dlsingh/temp_varun_rx_ant_UFL/README.md

this repo contains files rof varun rx with UFL antenna project
