dlsingh/temp_varun_rx_ant_UFL/varun_nr_at826_rx_bom_0.2_PCB_pwr.xlsx

Component | References | Value | Footprint | Supplied By | Quantity Per PCB | MFPN | Manufacturer | Distributor | Description | Vendor
1 | AE201 | SMA_Antenna |  | DYU Labs | 1 | Generic | Generic | Robu | Antenna with extra pin for shielding
2 | C1 | 220uF | CP_Radial_D6.3mm_P2.50mm | PCB Power | 1 | ESH227M010AE3AA | KEMET | Mouser | Polarized capacitor, small US symbol
3 | C102 C202 C401 | 0.1uF, 10V | C_0402_1005Metric | PCB Power | 3 | 0402ZD104KAT4A | kyocera AVX | Mouser | Unpolarized capacitor, small symbol | AVX
4 | C101 C201 | 10uF, 10V | C_1206_3216Metric | PCB Power | 2 | TAJA106K010SNJ | kyocera AVX | Mouser | Polarized capacitor, small symbol
5 | C2 C3 | 1uF, 10V | C_0805_2012Metric | PCB Power | 2 | CC0805KKX7R6BB105 | Yageo | Mouser | Unpolarized capacitor, small symbol
6 | D2 | AC_LED | LED_D3.0mm | DYU Labs | 1 | MCL034PT | Multicomp Pro | Element14 | Light emitting diode
7 | D1 | AS1M-HF | D_SMA | PCB Power | 1 | AS1M-HF | Comchip | Mouser | 1000V 1A General Purpose Rectifier Diode, DO-41
8 | D101 | LED_BGRA | LED_Cree_RGB_1.00x1.00mm_P0.2mm | PCB Power | 1 | uhd1110-fka-cl1a13r3q1bbqfmf3 | Cree LED | Mouser | RGB LED, blue/green/red/anode
9 | D3 | POWER_LED | LED_D3.0mm | DYU Labs | 1 | MCL034GT | Multicomp Pro | Element14 | Light emitting diode
10 | D301 D302 | S1M-HF | D_SMA | PCB Power | 2 | S1M-HF | Comchip | Mouser | 1000V, 1A, General Purpose Rectifier Diode, SMA(DO-214AC)
11 | F1 | Fuse_0.5A | Fuse_Schurter_UMT250 | PCB Power | 1 | 3405.0163.24 | Schurter | Mouser | Fuse, small symbol
12 | J103 | Conn_01x03 | PinHeader_1x03_P2.54mm_Vertical | DYU Labs | 1 | 22284030 | Molex | Generic | Generic connector, single row, 01x03, script generated (kicad-library-utils/schlib/autogen/connector/)
13 | J104 J401 | Conn_01x03 | JST_PH_B3B-PH-K_1x03_P2.00mm_Vertical | DYU Labs | 2 | B3B-PH-KS | JST | Generic | Generic connector, single row, 01x03, script generated (kicad-library-utils/schlib/autogen/connector/)
14 | J202 | Conn_Coaxial | SMA_Amphenol_901-143_Horizontal | DYU Labs | 1 | 73391-0083 | Molex | Mouser | coaxial connector (BNC, SMA, SMB, SMC, Cinch/RCA, LEMO, ...)
15 | J1 J302 J303 | Screw_Terminal_01x02 | CUI_TB002-500-02BE | PCB Power | 3 | TB002-500-02BE | CUI Devices | Mouser | Generic screw terminal, single row, 01x02, script generated (kicad-library-utils/schlib/autogen/connector/)
16 | K301 K302 | AZ943-1CH-5DE | Relay_SPDT_SANYOU_SRD_Series_Form_C | PCB Power | 2 | AZ943-1CH-5DE | American Zettler | DigiKey | Omron G5LE relay, Miniature Single Pole, SPDT, 10A
17 | PS1 | HLK-PM01 | Converter_ACDC_HiLink_HLK-PMxx | DYU Labs | 1 | HLK-PM01 | HiLink | Rajguru | Compact AC/DC board mount power module 3W 5V
18 | Q301 Q302 | Q_NPN_BEC | TSOT-23 | PCB Power | 2 | PMBT3904,235 | Nexperia | Mouser | NPN transistor, base/emitter/collector
19 | R2 R104 R105 R106 | 220 | R_0402_1005Metric | PCB Power | 4 | WR04X221JTL | Walsin | Mouser | Resistor, small US symbol
20 | R301 R302 | 2.74K | R_0402_1005Metric | PCB Power | 2 | WR04X2741FTL | Walsin | Mouser | Resistor, small US symbol
21 | R102 | 10K | R_0402_1005Metric | PCB Power | 1 | WR04X103JTL | Walsin | Mouser | Resistor, small US symbol
22 | R1 | 100K | R_0805_2012Metric | PCB Power | 1 | ERJ-P06J104V | KOA Speer | Mouser | Resistor, small US symbol
23 | RV1 | 10D561 | RV_Disc_D12mm_W5.1mm_P7.5mm | PCB Power | 1 | MOV-10D561K | Bornus | Mouser | Voltage dependent resistor, US symbol
24 | SW102 | SW_MEC_5E | RKB2SJM250SMTR_LFS_SWITCH | PCB Power | 1 | PTS815 SJM 250 SMTR LFS |  | Mouser | MEC 5E single pole normally-open tactile switch
25 | U101 | ATtiny826-M | VQFN-20-1EP_3x3mm_P0.4mm_EP1.7x1.7mm | DYU Labs | 1 | ATTINY826-M | Microchip | Mouser | 20MHz, 8kB Flash, 1kB SRAM, 128B EEPROM, VQFN-20
26 | U1 | NCP115ASN330T2G | TSOP-5_1.65x3.05mm_P0.95mm | PCB Power | 1 | NCP115ASN330T2G | Onsemi | Mouser
27 | U201 | NiceRF-LoRa127x-C1-xxx | NiceRF-LoRa127X-C1-xxx | DYU Labs | 1 | Lora1276-C1-868 | NiceRF | NiceRF
Component Groups: | 30
Component Count: | 44
Fitted Components: | 41
Number of PCBs: | 1
Total components: | 41
Schematic Version: | 0.2
Schematic Date: | 2022-08-05
PCB Variant: | a
BoM Date: | 2022-08-16 11:27
Schematic Source: | varun_nr_at826_rx.kicad_sch
KiCad Version: | Eeschema (6.0.1)
