dlsingh/temp_varun_rx_ant_UFL/varun_nr_at826_rx.kicad_pcb

## KiCad design varun_nr_at826_rx.kicad_pcb (2022-08-17)

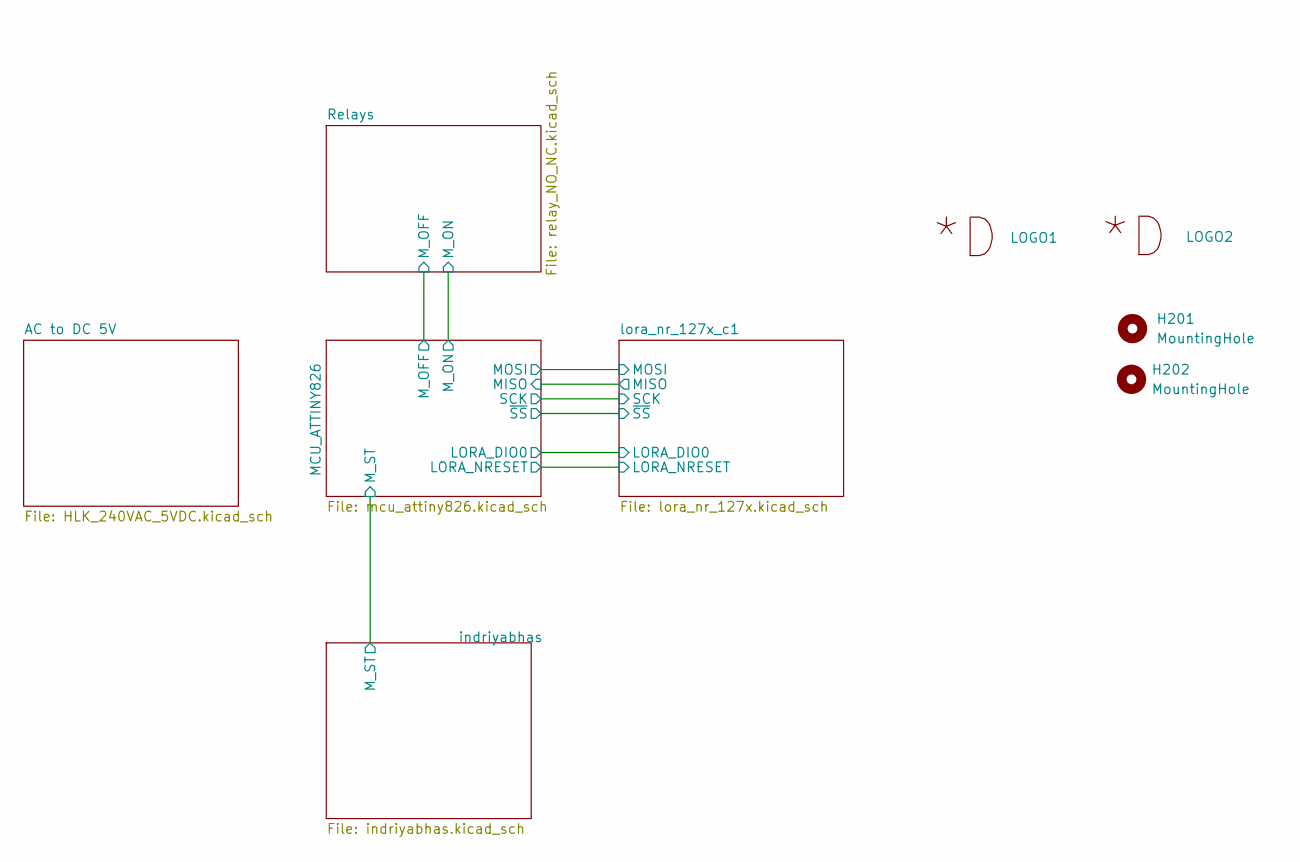
[picture p1: schematic varun_nr_at826_rx.kicad_sch, varun_rx]

Parts:
H201, H202: MountingHole; MountingHole_3mm
LOGO1, LOGO2: Dyulabs_logo; D_logo

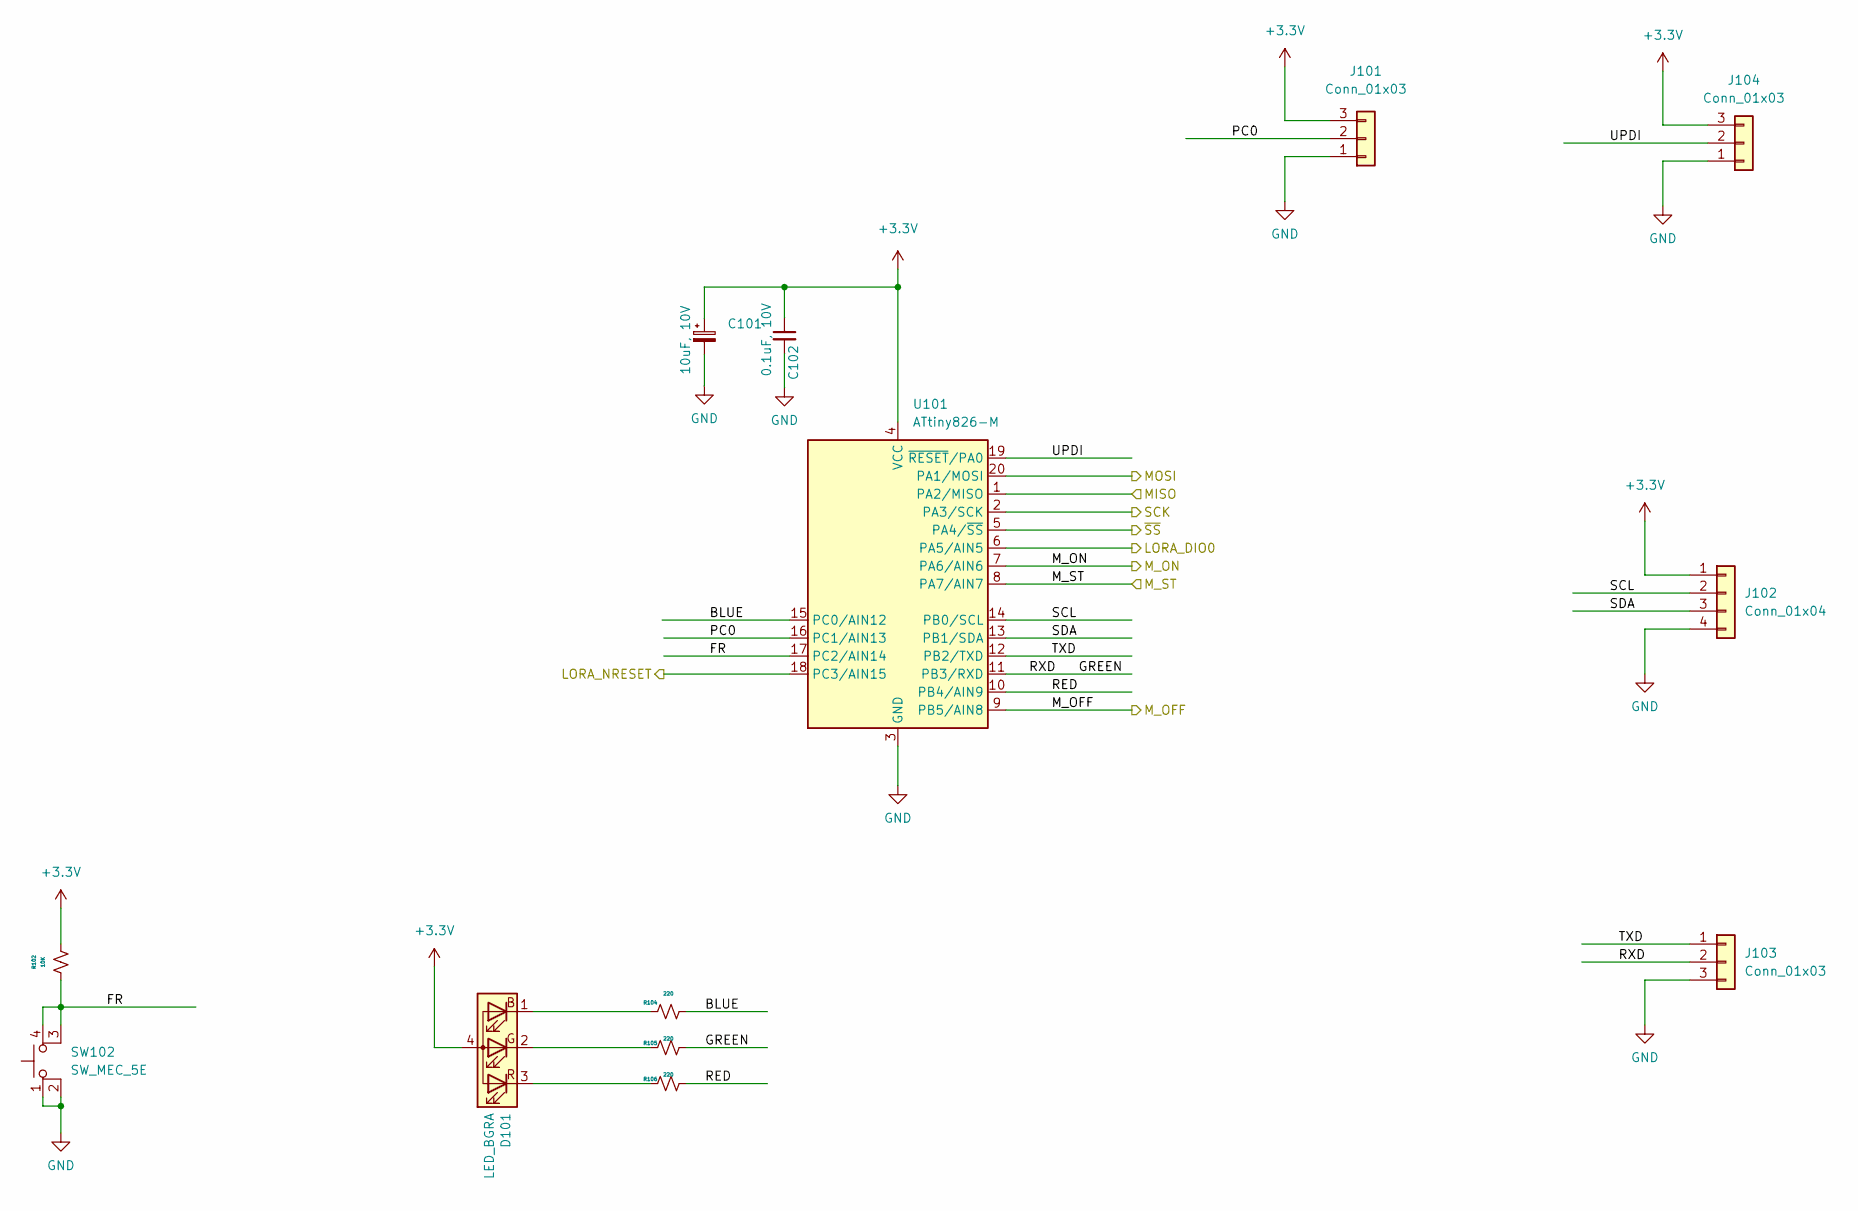
[picture p2: schematic mcu_attiny826.kicad_sch, varun_rx]

Parts:
C101: 10uF, 10V; C_1206_3216Metric
C102: 0.1uF, 10V; C_0402_1005Metric
D101: LED_BGRA; LED_Cree_RGB_1.00x1.00mm_P0.2mm
J101, J103: Conn_01x03; PinHeader_1x03_P2.54mm_Vertical
J102: Conn_01x04; PinHeader_1x04_P2.54mm_Vertical
J104: Conn_01x03; JST_PH_B3B-PH-K_1x03_P2.00mm_Vertical
R102: 10K; R_0402_1005Metric
R104, R105, R106: 220; R_0402_1005Metric
SW102: SW_MEC_5E; RKB2SJM250SMTR_LFS_SWITCH
U101: ATtiny826-M; VQFN-20-1EP_3x3mm_P0.4mm_EP1.7x1.7mm

Connections:
+3V3: C101.1, C102.1, D101.4 (A), J101.3, J102.1, J104.3, R102.2, U101.4 (VCC); also elsewhere on the board
/MCU_ATTINY826/BLUE: R104.1, U101.15 (PC0/AIN12)
/MCU_ATTINY826/FR: R102.1, SW102.3 (K), SW102.4 (A), U101.17 (PC2/AIN14)
/MCU_ATTINY826/GREEN: J103.2, R105.1, U101.11 (PB3/RXD)
/MCU_ATTINY826/LORA_DIO0: U101.6 (PA5/AIN5); also elsewhere on the board
/MCU_ATTINY826/LORA_NRESET: U101.18 (PC3/AIN15); also elsewhere on the board
/MCU_ATTINY826/MISO: U101.1 (PA2/MISO); also elsewhere on the board
/MCU_ATTINY826/MOSI: U101.20 (PA1/MOSI); also elsewhere on the board
/MCU_ATTINY826/M_OFF: U101.9 (PB5/AIN8); also elsewhere on the board
/MCU_ATTINY826/M_ON: U101.7 (PA6/AIN6); also elsewhere on the board
/MCU_ATTINY826/M_ST: U101.8 (PA7/AIN7); also elsewhere on the board
/MCU_ATTINY826/PC0: J101.2, U101.16 (PC1/AIN13)
/MCU_ATTINY826/RED: R106.1, U101.10 (PB4/AIN9)
/MCU_ATTINY826/SCK: U101.2 (PA3/SCK); also elsewhere on the board
/MCU_ATTINY826/SCL: J102.2, U101.14 (PB0/SCL)
/MCU_ATTINY826/SDA: J102.3, U101.13 (PB1/SDA)
/MCU_ATTINY826/TXD: J103.1, U101.12 (PB2/TXD)
/MCU_ATTINY826/UPDI: J104.2, U101.19 (~RESET/PA0)
/MCU_ATTINY826/~SS: U101.5 (PA4/~SS); also elsewhere on the board
GND: C101.2, C102.2, J101.1, J102.4, J103.3, J104.1, SW102.1, SW102.2, U101.3 (GND), U101.21 (GND); also elsewhere on the board
unnamed: D101.1 (BK), R104.2
unnamed: D101.2 (GK), R105.2
unnamed: D101.3 (RK), R106.2

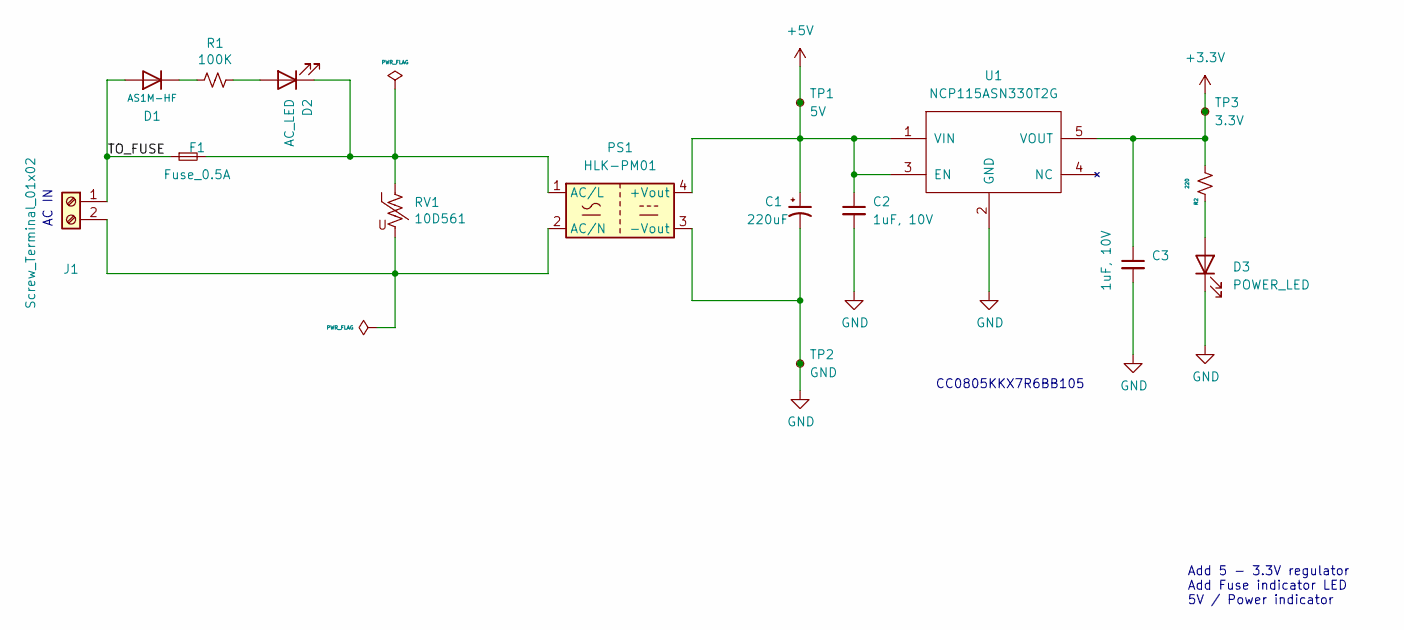
[picture p3: schematic HLK_240VAC_5VDC.kicad_sch, varun_rx]

Parts:
C1: 220uF; CP_Radial_D6.3mm_P2.50mm
C2, C3: 1uF, 10V; C_0805_2012Metric
D1: AS1M-HF; D_SMA
D2: AC_LED; LED_D3.0mm
D3: POWER_LED; LED_D3.0mm
F1: Fuse_0.5A; Fuse_Schurter_UMT250
J1: Screw_Terminal_01x02; CUI_TB002-500-02BE
PS1: HLK-PM01; Converter_ACDC_HiLink_HLK-PMxx
R1: 100K; R_0805_2012Metric
R2: 220; R_0402_1005Metric
RV1: 10D561; RV_Disc_D12mm_W5.1mm_P7.5mm
TP1: 5V; TestPoint_THTPad_D1.0mm_Drill0.5mm
TP2: GND; TestPoint_THTPad_D1.0mm_Drill0.5mm
TP3: 3.3V; TestPoint_THTPad_D1.0mm_Drill0.5mm
U1: NCP115ASN330T2G; TSOP-5_1.65x3.05mm_P0.95mm

Connections:
+3V3: C3.1, R2.1, TP3.1, U1.5 (VOUT); also elsewhere on the board
+5V: C1.1, C2.1, PS1.4 (+Vout), TP1.1, U1.1 (VIN), U1.3 (EN); also elsewhere on the board
/AC to DC 5V/TO_FUSE: D1.2 (A), F1.1, J1.1
GND: C1.2, C2.2, C3.2, D3.1 (K), PS1.3 (-Vout), TP2.1, U1.2 (GND); also elsewhere on the board
unnamed: D1.1 (K), R1.2
unnamed: D2.1 (K), F1.2, PS1.1 (AC/L), RV1.1
unnamed: D2.2 (A), R1.1
unnamed: D3.2 (A), R2.2
unnamed: J1.2, PS1.2 (AC/N), RV1.2

Notes on the sheet:
AC IN
CC0805KKX7R6BB105
Add 5 - 3.3V regulator Add Fuse indicator LED 5V / Power indicator

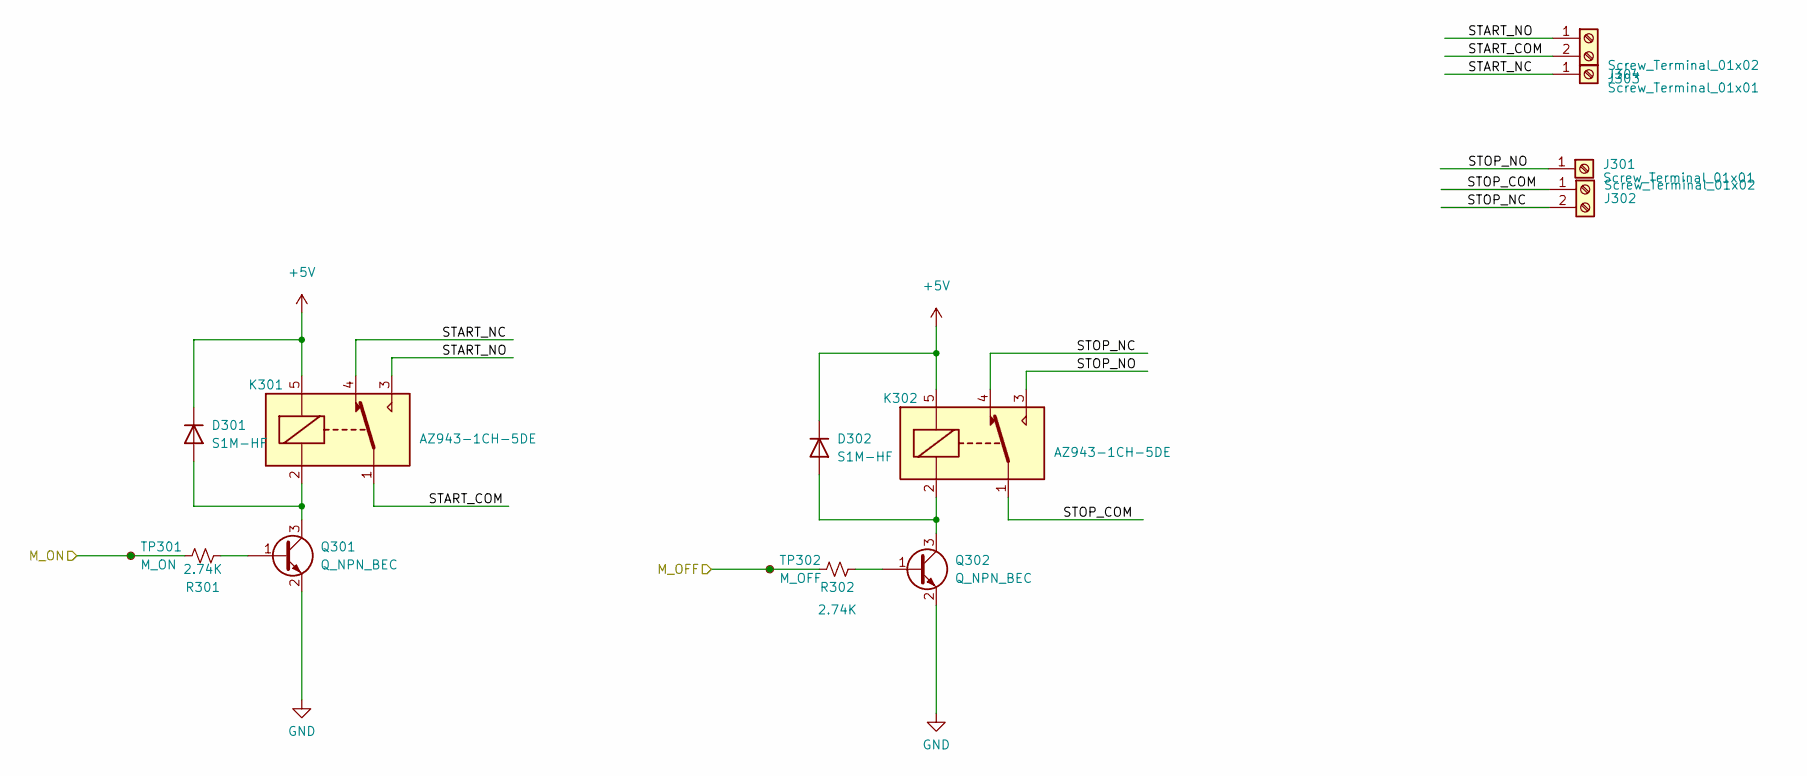
[picture p4: schematic relay_NO_NC.kicad_sch, varun_rx]

Parts:
D301, D302: S1M-HF; D_SMA
J301, J304: Screw_Terminal_01x01; PinHeader_1x01_P2.54mm_Vertical
J302, J303: Screw_Terminal_01x02; CUI_TB002-500-02BE
K301, K302: AZ943-1CH-5DE; Relay_SPDT_SANYOU_SRD_Series_Form_C
Q301, Q302: Q_NPN_BEC; TSOT-23
R301, R302: 2.74K; R_0402_1005Metric
TP301: M_ON; TestPoint_THTPad_D1.0mm_Drill0.5mm
TP302: M_OFF; TestPoint_THTPad_D1.0mm_Drill0.5mm

Connections:
+5V: D301.1 (K), D302.1 (K), K301.5, K302.5; also elsewhere on the board
/MCU_ATTINY826/M_OFF: R302.2, TP302.1; also elsewhere on the board
/MCU_ATTINY826/M_ON: R301.2, TP301.1; also elsewhere on the board
/Relays/START_COM: J303.2, K301.1
/Relays/START_NC: J304.1, K301.4
/Relays/START_NO: J303.1, K301.3
/Relays/STOP_COM: J302.1, K302.1
/Relays/STOP_NC: J302.2, K302.4
/Relays/STOP_NO: J301.1, K302.3
GND: Q301.2 (E), Q302.2 (E); also elsewhere on the board
unnamed: D301.2 (A), K301.2, Q301.3 (C)
unnamed: D302.2 (A), K302.2, Q302.3 (C)
unnamed: Q301.1 (B), R301.1
unnamed: Q302.1 (B), R302.1

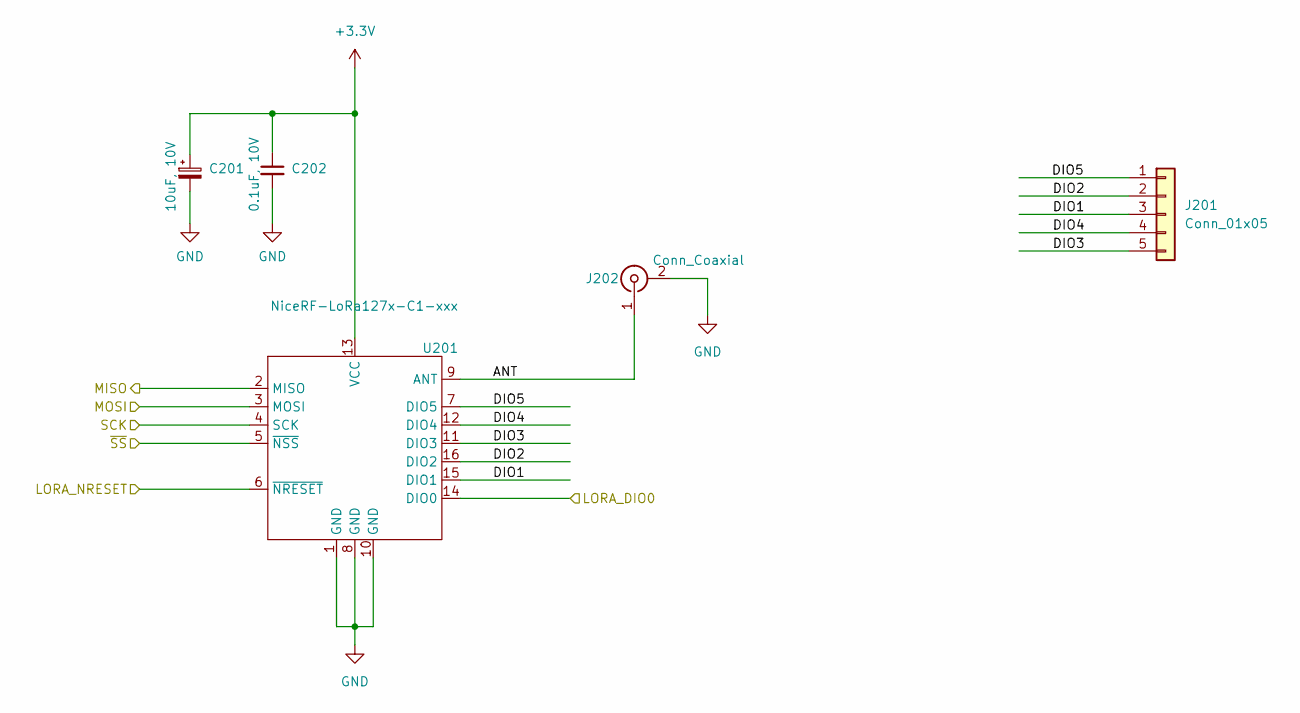
[picture p5: schematic lora_nr_127x.kicad_sch, varun_rx]

Parts:
C201: 10uF, 10V; C_1206_3216Metric
C202: 0.1uF, 10V; C_0402_1005Metric
J201: Conn_01x05; PinHeader_1x05_P2.54mm_Vertical
J202: Conn_Coaxial; U.FL_Molex_MCRF_73412-0110_Vertical
U201: NiceRF-LoRa127x-C1-xxx; NiceRF-LoRa127X-C1-xxx

Connections:
+3V3: C201.1, C202.1, U201.13 (VCC); also elsewhere on the board
/MCU_ATTINY826/LORA_DIO0: U201.14 (DIO0); also elsewhere on the board
/MCU_ATTINY826/LORA_NRESET: U201.6 (~NRESET); also elsewhere on the board
/MCU_ATTINY826/MISO: U201.2 (MISO); also elsewhere on the board
/MCU_ATTINY826/MOSI: U201.3 (MOSI); also elsewhere on the board
/MCU_ATTINY826/SCK: U201.4 (SCK); also elsewhere on the board
/MCU_ATTINY826/~SS: U201.5 (~NSS); also elsewhere on the board
/lora_nr_127x_c1/ANT: J202.1 (In), U201.9 (ANT)
/lora_nr_127x_c1/DIO1: J201.3, U201.15 (DIO1)
/lora_nr_127x_c1/DIO2: J201.2, U201.16 (DIO2)
/lora_nr_127x_c1/DIO3: J201.5, U201.11 (DIO3)
/lora_nr_127x_c1/DIO4: J201.4, U201.12 (DIO4)
/lora_nr_127x_c1/DIO5: J201.1, U201.7 (DIO5)
GND: C201.2, C202.2, J202.2 (Ext), U201.1 (GND), U201.8 (GND), U201.10 (GND); also elsewhere on the board

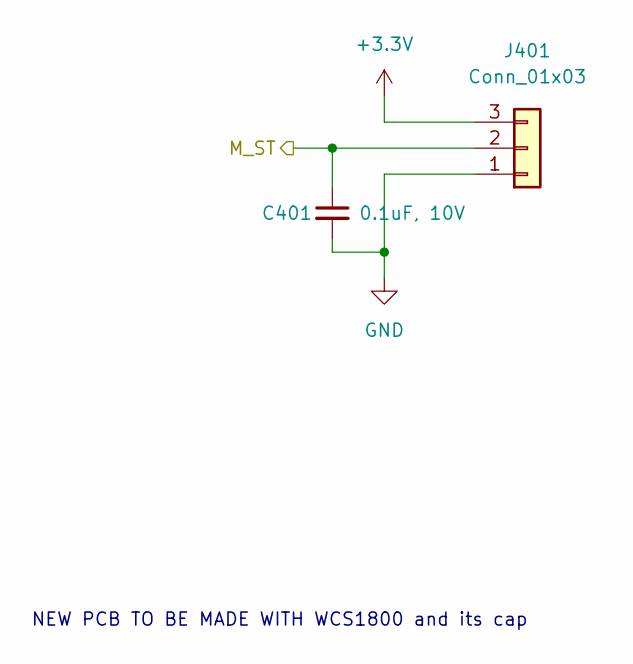
[picture p6: schematic indriyabhas.kicad_sch, varun_rx]

Parts:
C401: 0.1uF, 10V; C_0402_1005Metric
J401: Conn_01x03; JST_PH_B3B-PH-K_1x03_P2.00mm_Vertical

Connections:
+3V3: J401.3; also elsewhere on the board
/MCU_ATTINY826/M_ST: C401.1, J401.2; also elsewhere on the board
GND: C401.2, J401.1; also elsewhere on the board

Notes on the sheet:
NEW PCB TO BE MADE WITH WCS1800 and its cap

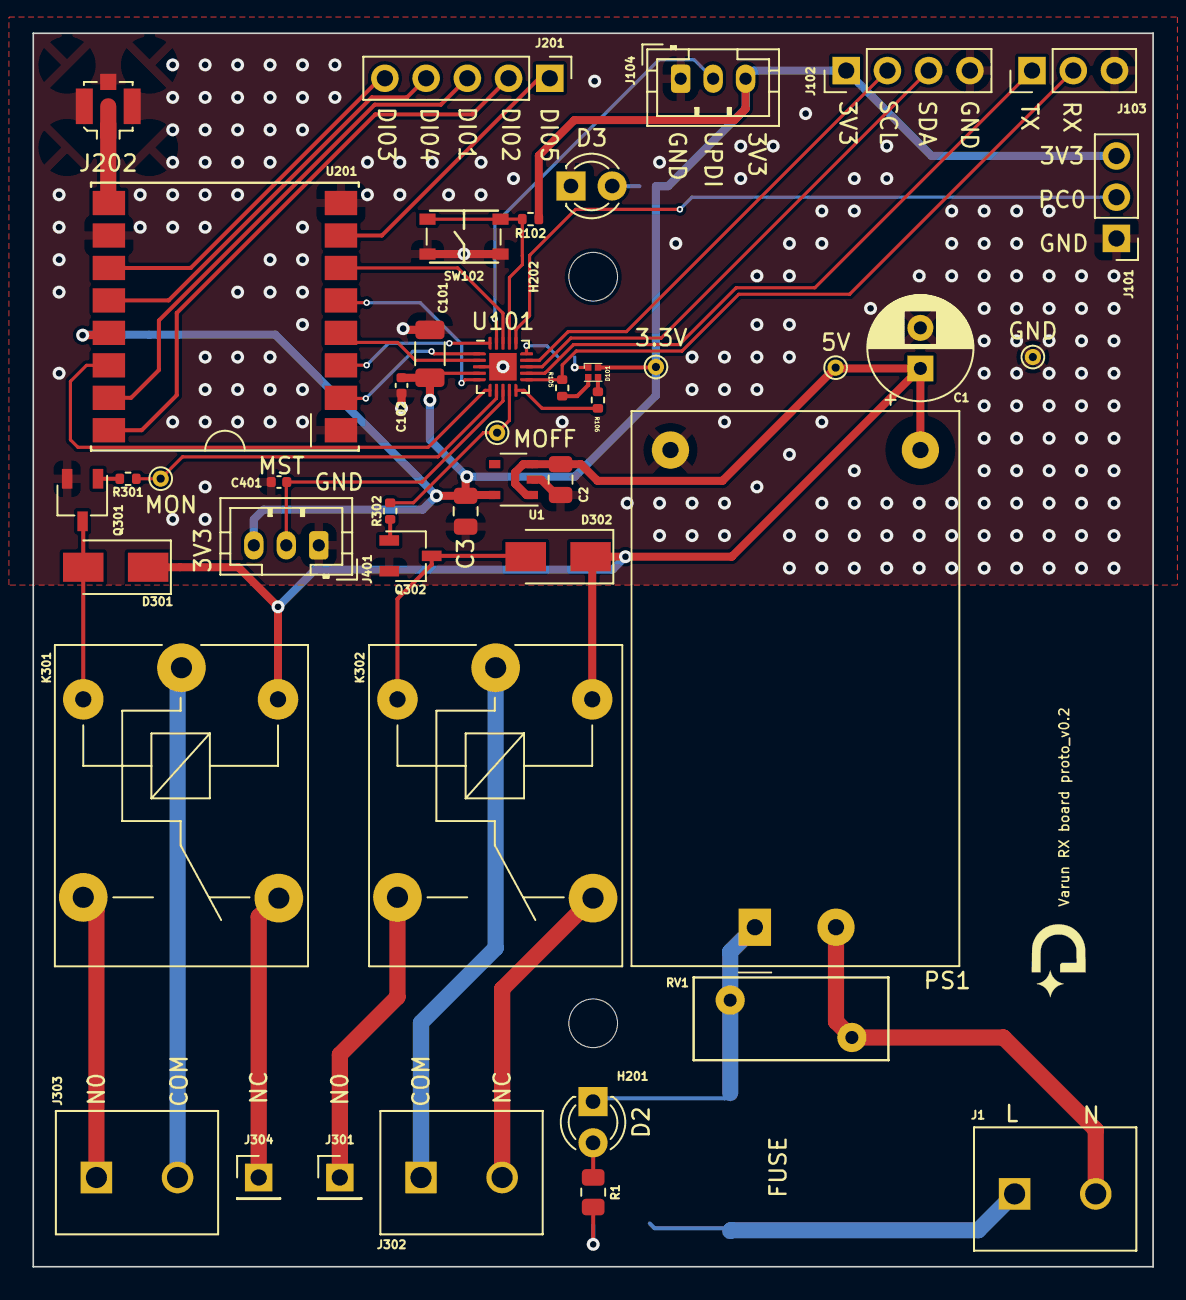
[picture p7: board varun_nr_at826_rx.kicad_pcb from above]

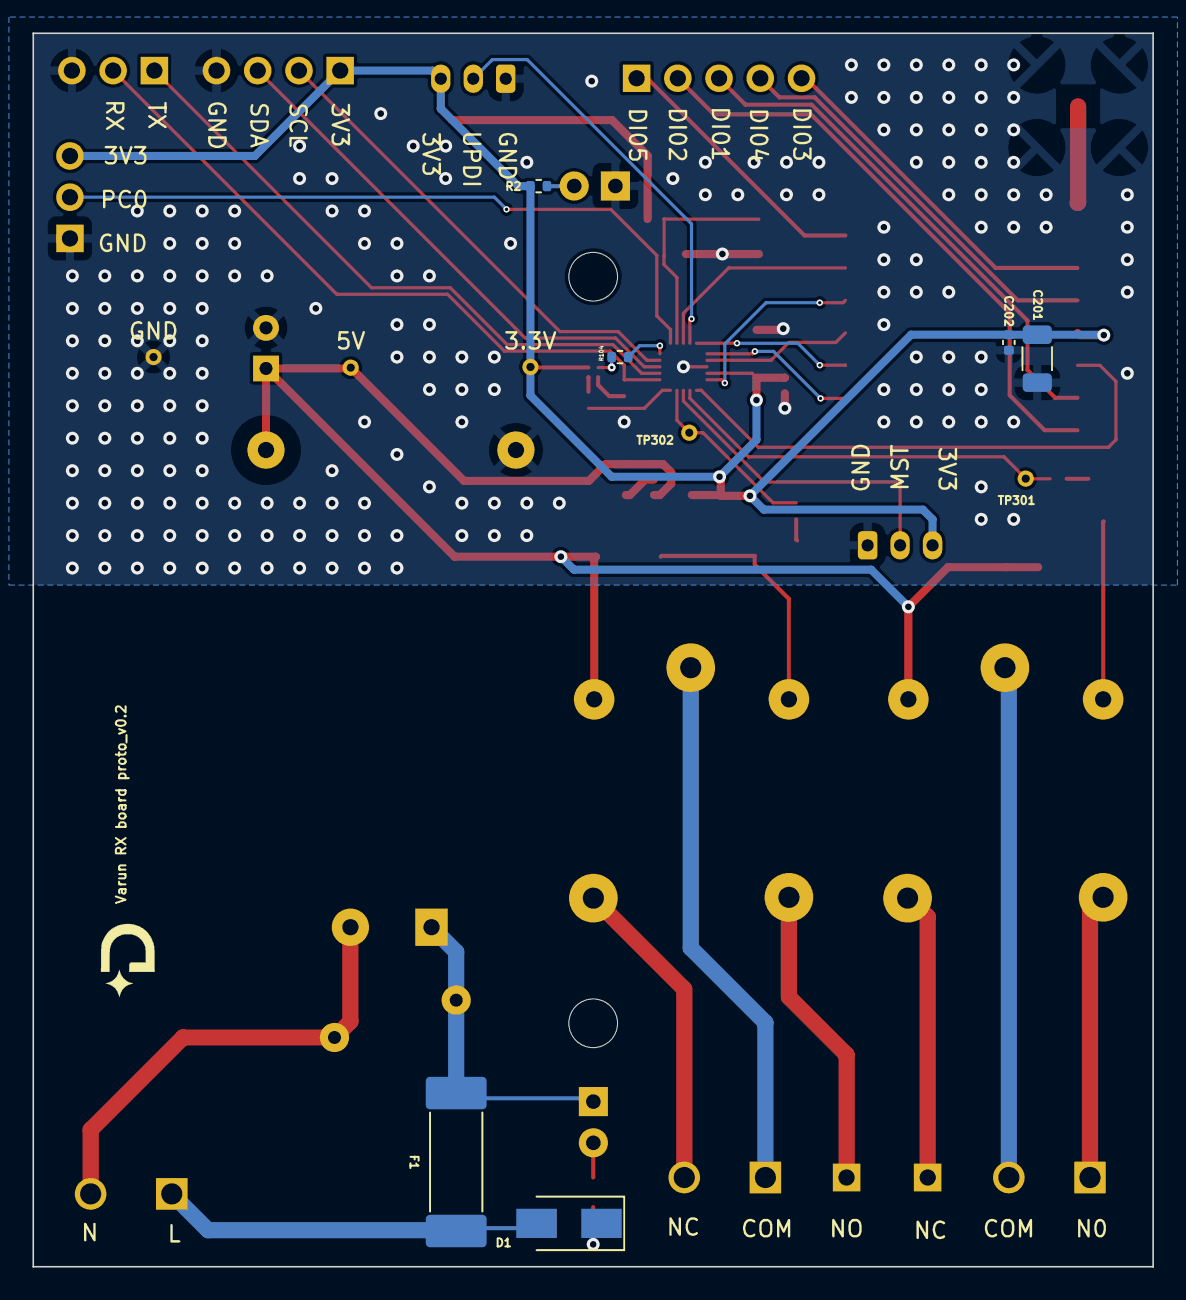
[picture p8: board varun_nr_at826_rx.kicad_pcb from below]

Board: 2 copper layers, 69.0 x 76.0 mm, 54 parts (7 on the bottom side), 46 nets.
